Gigahawk/reprapdiscount_smart_controller/ALTIUM_EMBEDDED_MODELS/res0805.STEP

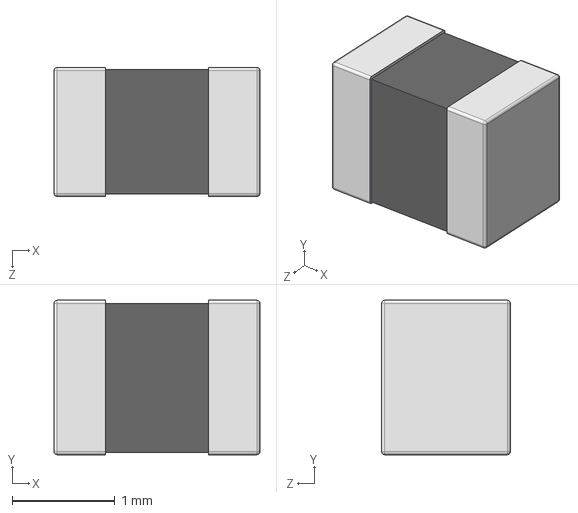
[picture p1: CAD file, 2023-08-28]
ALTIUM_EMBEDDED_MODELS/res0805.STEP
2.00 x 1.50 x 1.25 mm
