Gigahawk/reprapdiscount_smart_controller/ALTIUM_EMBEDDED_MODELS/res1206.STEP

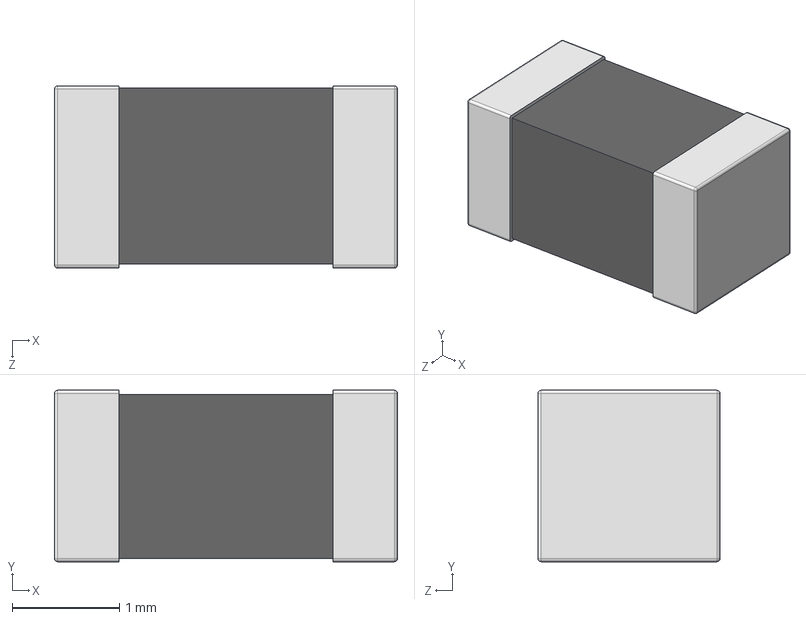
[picture p2: CAD file, 2023-08-28]
ALTIUM_EMBEDDED_MODELS/res1206.STEP
3.20 x 1.60 x 1.70 mm
