Gigahawk/reprapdiscount_smart_controller/(list of files, cad)

Other CAD files:
ALTIUM_EMBEDDED_MODELS/CAP0805.STEP
