Gigahawk/reprapdiscount_smart_controller/reprapdiscount_smart_controller.kicad_pcb

## KiCad design reprapdiscount_smart_controller.kicad_pcb (2023-10-04)

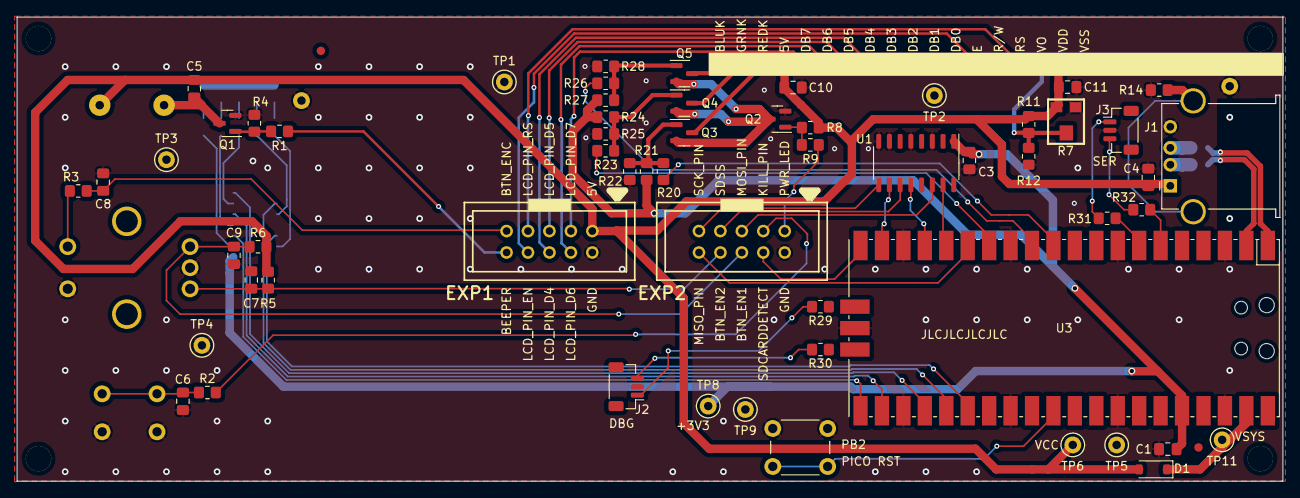
[picture p3: board reprapdiscount_smart_controller.kicad_pcb from above]

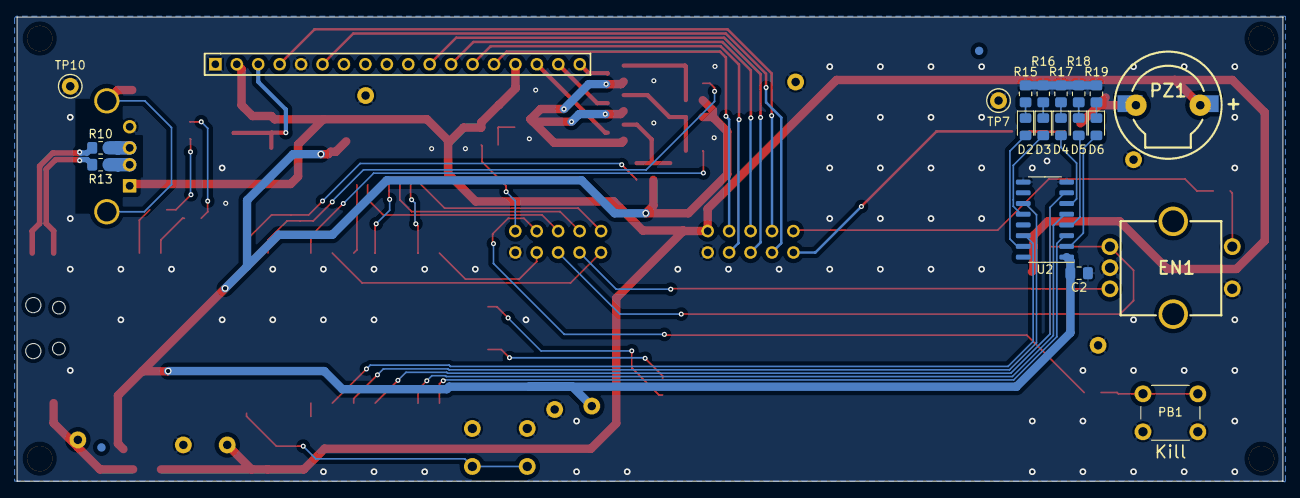
[picture p4: board reprapdiscount_smart_controller.kicad_pcb from below]

Board: 2 copper layers, 150.0 x 55.0 mm, 87 parts (23 on the bottom side), 69 nets.

Parts:
C1, C4, C10, C11: 10u; C_0805_2012Metric_Pad1.18x1.45mm_HandSolder
C2, C3, C5, C6, C7, C8, C9: 100n; C_0805_2012Metric_Pad1.18x1.45mm_HandSolder
D1: MBR120; D_SOD-123
D2: RED; LED_0805_2012Metric_Pad1.15x1.40mm_HandSolder
D3: GRN; LED_0805_2012Metric_Pad1.15x1.40mm_HandSolder
D4: BLU; LED_0805_2012Metric_Pad1.15x1.40mm_HandSolder
D5: YLW; LED_0805_2012Metric_Pad1.15x1.40mm_HandSolder
D6: WHT; LED_0805_2012Metric_Pad1.15x1.40mm_HandSolder
EN1: BC111E5244B2; ROTARY ENCODER
EXP1, EXP2: Header 5X2; HDR2X5_EXP
FID1, FID2, FID3, FID4: Fiducial; Fiducial_1mm_Mask2mm
H1, H2, H3, H4: MountingHole; MountingHole_3mm
J1: USB_A; USB_A_Stewart_SS-52100-001_Horizontal
J2, J3: Conn_01x03_Pin; JST_SH_BM03B-SRSS-TB_1x03-1MP_P1.00mm_Vertical
LCD1: Character lcd; HDR1X18
PB1: STOP; SW_PUSH_6mm_H7.3mm
PB2: PICO RST; SW_PUSH_6mm_H7.3mm
PZ1: PIEZO; PIEZO 11MM
Q1, Q2, Q3, Q4, Q5: DMN2005K-7; SOT-23
R1, R4, R9, R14, R20, R23, R26: 0R; R_0805_2012Metric_Pad1.20x1.40mm_HandSolder
R2: 1k; R_0805_2012Metric_Pad1.20x1.40mm_HandSolder
R3, R29, R30, R31, R32: 100R; R_0805_2012Metric_Pad1.20x1.40mm_HandSolder
R5, R6: 5.1k; R_0805_2012Metric_Pad1.20x1.40mm_HandSolder
R7: 1.4k; RES TRIMPOT
R8, R21, R22, R24, R25, R27, R28: 10k; R_0805_2012Metric_Pad1.20x1.40mm_HandSolder
R10, R13: 22R; R_0805_2012Metric_Pad1.20x1.40mm_HandSolder
R11: DNI; R_0805_2012Metric_Pad1.20x1.40mm_HandSolder
R12: 470R; R_0805_2012Metric_Pad1.20x1.40mm_HandSolder
R15, R16, R18: 91R; R_0805_2012Metric_Pad1.20x1.40mm_HandSolder
R17, R19: 33R; R_0805_2012Metric_Pad1.20x1.40mm_HandSolder
SYM1: Logo_Open_Hardware_Large; OSHW-Logo2_9.8x8mm_Mask
TP1, TP2, TP3, TP4, TP5, TP6, TP7, TP8, TP9, TP10, TP11: TestPoint; TestPoint_Keystone_5000-5004_Miniature
U1, U2: 74HC4050; SO-16_3.9x9.9mm_P1.27mm
U3: Pico; RPi_Pico_SMD_NO_SILK

Connections:
+3V3: C1.2, C2.2, C3.2, R21.2, R24.2, R27.2, TP8.1, U1.1 (+), U2.1 (+), U3.36 (3V3)
BEEPER: EXP1.1, R1.2
BLUK: LCD1.18 (BLUK-), Q5.3 (D)
BTN_EN1: C9.1, EN1.1, EXP2.5, R6.1
BTN_EN2: C7.2, EN1.3, EXP2.3, R5.1
BTN_ENC: C8.2, EXP1.2, R3.1
CONN_D+: J1.3 (D+), R10.2
CONN_D-: J1.2 (D-), R13.2
DBG_RX: R31.1, U3.7 (GPIO5)
DBG_TX: R32.1, U3.6 (GPIO4)
GND: C1.1, C2.1, C3.1, C4.1, C6.1, C7.1, C8.1, C9.2, C10.1, C11.1, EN1.2, EN1.4, EXP1.9, EXP2.9, J1.4 (GND), J2.2, J3.2, LCD1.1 (GND), LCD1.5 (R/W), PB1.2, PB2.2, Q1.2 (S), Q2.2 (S), R4.2, R7.1, R12.2, R14.2, R15.1, R16.1, R17.1, R18.1, R19.1, R22.1, R25.1, R28.1, TP1.1, TP2.1, TP3.1, TP4.1, TP5.1, TP7.1, TP9.1, TP10.1, U1.3, U1.5, U1.7, U1.8 (G), U2.8 (G), U2.9, U3.3 (GND), U3.8 (GND), U3.13 (GND), U3.18 (GND), U3.23 (GND), U3.28 (GND), U3.33 (AGND), U3.38 (GND), U3.42 (GND)
GRNK: LCD1.17 (GRNK-), Q4.3 (D)
HOST_CS: EXP2.4, U1.11
HOST_MOSI: EXP2.6, U1.14
HOST_SCK: EXP2.2, U1.9
LCD4: EXP1.5, LCD1.11 (D4)
LCD5: EXP1.6, LCD1.12 (D5)
LCD6: EXP1.7, LCD1.13 (D6)
LCD7: EXP1.8, LCD1.14 (D7)
LCDE: EXP1.3, LCD1.6 (E)
LCDRS: EXP1.4, LCD1.4 (RS)
LED1: U2.14, U3.26 (GPIO20)
LED2: U2.11, U3.25 (GPIO19)
LED3: U2.7, U3.24 (GPIO18)
LED4: U2.5, U3.22 (GPIO17)
LED5: U2.3, U3.21 (GPIO16)
LEDB: R26.2, U3.12 (GPIO9)
LEDG: R23.2, U3.14 (GPIO10)
LEDK: Q2.3 (D), Q3.2 (S), Q4.2 (S), Q5.2 (S)
LEDR: R20.2, U3.11 (GPIO8)
unnamed: C6.2, PB1.1, R2.1
unnamed: D2.2 (A), U2.15
unnamed: D2.1 (K), R15.2
unnamed: D3.2 (A), U2.12
unnamed: D3.1 (K), R16.2
unnamed: D4.2 (A), U2.6
unnamed: D4.1 (K), R17.2
unnamed: D5.2 (A), U2.4
unnamed: D5.1 (K), R18.2
unnamed: D6.2 (A), U2.2
unnamed: D6.1 (K), R19.2
unnamed: EN1.5, R3.2
unnamed: J1.5 (Shield), R14.1
unnamed: J2.1, R29.2
unnamed: J2.3, R30.2
unnamed: J3.1, R31.2
unnamed: J3.3, R32.2
unnamed: LCD1.3 (Vo), R7.2, R11.2, R12.1
unnamed: C5.1, PZ1.2 (+), Q1.3 (D)
unnamed: Q1.1 (G), R1.1, R4.1
unnamed: Q2.1 (G), R8.1, R9.1
unnamed: Q3.1 (G), R20.1, R21.1, R22.2
unnamed: Q4.1 (G), R23.1, R24.1, R25.2
unnamed: Q5.1 (G), R26.1, R27.1, R28.2
PICO_RST: PB2.1, U3.30 (RUN)
PWR_LED: EXP2.10, R9.2
REDK: LCD1.16 (REDK-), Q3.3 (D)
RESET: EXP2.8, R2.2
SD_CS: U1.12, U3.17 (GPIO13)
SD_DET: EXP2.7, U3.20 (GPIO15)
SD_MISO: EXP2.1, U3.15 (GPIO11)
SD_MOSI: U1.15, U3.16 (GPIO12)
SD_SCK: U1.10, U3.19 (GPIO14)
SWCLK: R29.1, U3.41 (SWCLK)
SWDIO: R30.1, U3.43 (SWDIO)
USB_D+: R10.1, U3.1 (GPIO0)
USB_D-: R13.1, U3.2 (GPIO1)
VCC: C4.2, C5.2, C10.2, C11.2, D1.2 (A), EXP1.10, J1.1 (VBUS), LCD1.2 (Vcc), LCD1.15 (A+), PZ1.1 (-), R5.2, R6.2, R7.3, R8.2, R11.1, TP6.1
VSYS: D1.1 (K), TP11.1, U3.39 (VSYS)
