Gigahawk/reprapdiscount_smart_controller/reprapdiscount_ramps_controller_adapter.kicad_pcb

## KiCad design reprapdiscount_ramps_controller_adapter.kicad_pcb (2023-10-04)

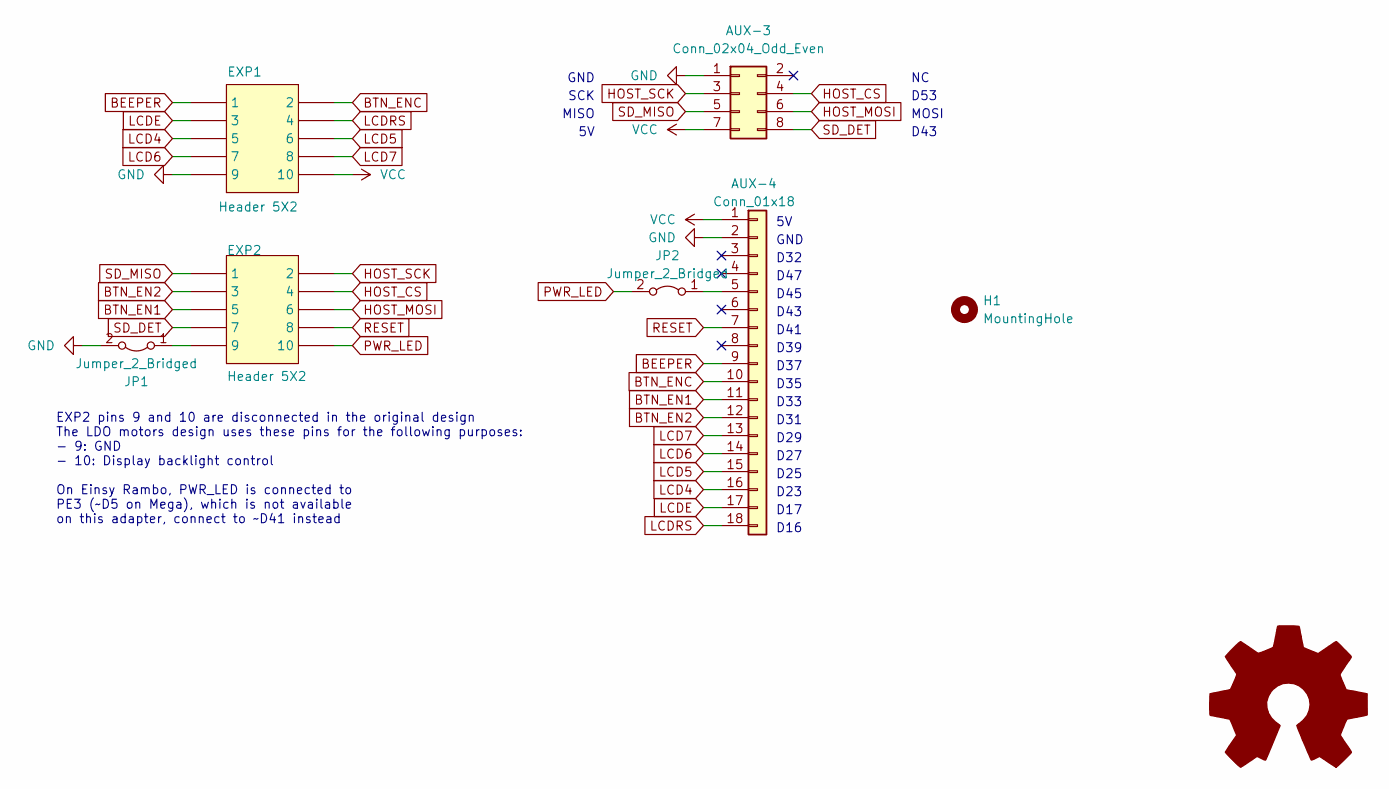
[picture p5: schematic reprapdiscount_ramps_controller_adapter.kicad_sch, RepRapDiscount.com Ramps Smart Adapter]

Parts:
AUX-3: Conn_02x04_Odd_Even; PinSocket_2x04_P2.54mm_Vertical_Flipped
AUX-4: Conn_01x18; PinSocket_1x18_P2.54mm_Vertical
EXP1, EXP2: Header 5X2; PinHeader_2x05_P2.54mm_Vertical; Digikey 1175-1627-ND
H1: MountingHole; MountingHole_3.7mm
JP1, JP2: Jumper_2_Bridged; SolderJumper-2_P1.3mm_Bridged_RoundedPad1.0x1.5mm
SYM1: Logo_Open_Hardware_Large; OSHW-Logo2_7.3x6mm_Mask

Connections:
BEEPER: AUX-4.9, EXP1.1
BTN_EN1: AUX-4.11, EXP2.5
BTN_EN2: AUX-4.12, EXP2.3
BTN_ENC: AUX-4.10, EXP1.2
GND: AUX-3.1, AUX-4.2, EXP1.9, JP1.2 (B)
HOST_CS: AUX-3.4, EXP2.4
HOST_MOSI: AUX-3.6, EXP2.6
HOST_SCK: AUX-3.3, EXP2.2
LCD4: AUX-4.16, EXP1.5
LCD5: AUX-4.15, EXP1.6
LCD6: AUX-4.14, EXP1.7
LCD7: AUX-4.13, EXP1.8
LCDE: AUX-4.17, EXP1.3
LCDRS: AUX-4.18, EXP1.4
unnamed: AUX-4.5, JP2.1 (A)
unnamed: EXP2.9, JP1.1 (A)
PWR_LED: EXP2.10, JP2.2 (B)
RESET: AUX-4.7, EXP2.8
SD_DET: AUX-3.8, EXP2.7
SD_MISO: AUX-3.5, EXP2.1
VCC: AUX-3.7, AUX-4.1, EXP1.10

Notes on the sheet:
D27
D45
D17
EXP2 pins 9 and 10 are disconnected in the original design The LDO motors design uses these pins for the following purposes: - 9: GND - 10: Display backlight control On Einsy Rambo, PWR_LED is connected to PE3 (~D5 on Mega), which is not available on this adapter, connect to ~D41 instead
D32
D37
D35
GND
D23
D43
D53
D47
MOSI
D25
D31
D16
MISO
SCK
D39
D33
D29
D41

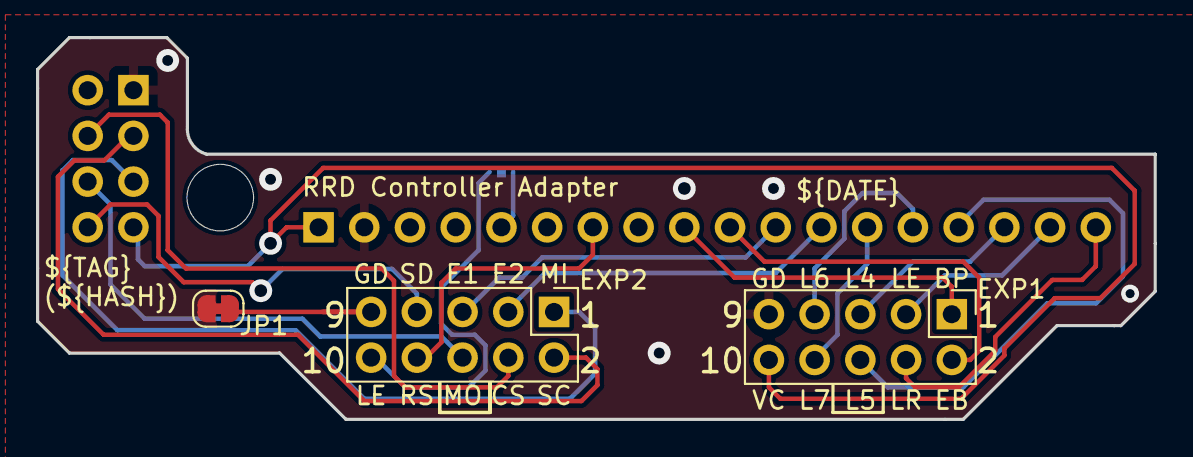
[picture p6: board reprapdiscount_ramps_controller_adapter.kicad_pcb from above]

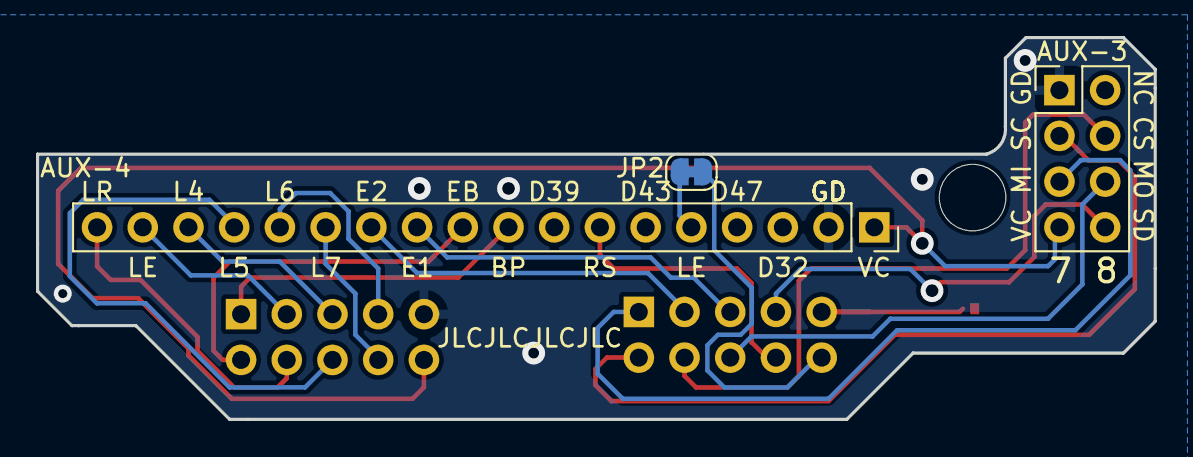
[picture p7: board reprapdiscount_ramps_controller_adapter.kicad_pcb from below]

Board: 2 copper layers, 62.1 x 21.2 mm, 8 parts (3 on the bottom side), 21 nets.
