Gigahawk/reprapdiscount_smart_controller/(commit log)

2023-08-28 import original altium project files
    [smart controller.PcbDoc, smart controller.PrjPcb, smart controller.SchDoc]
2023-08-28 rename files
    [reprapdiscount_smart_controller.PcbDoc, reprapdiscount_smart_controller.PrjPcb, reprapdiscount_smart_controller.SchDoc]
2023-08-28 convert altium files to kicad
    [CAP0805.STEP, reprapdiscount_smart_controller.PcbDoc, reprapdiscount_smart_controller.PrjPcb, reprapdiscount_smart_controller.SchDoc, reprapdiscount_smart_controller.kicad_pcb, reprapdiscount_smart_controller.kicad_sch, res0805.STEP, res1206.STEP]
2023-08-28 generate footprint library from layout
2023-08-28 fixup: fix schematic and layout references
    - replace random 3V3 pth footprints with vias
    [reprapdiscount_smart_controller.kicad_pcb, reprapdiscount_smart_controller.kicad_sch]
2023-08-28 fixup: switch to global net names
    [reprapdiscount_smart_controller.kicad_pcb, reprapdiscount_smart_controller.kicad_sch]
2023-08-28 fixup: switch to kicad native passive symbols
    - redo fill, cleanup broken connections
    [reprapdiscount_smart_controller.kicad_pcb, reprapdiscount_smart_controller.kicad_sch]
2023-08-29 fixup: add all missing 3d models
    [reprapdiscount_smart_controller.kicad_pcb, reprapdiscount_smart_controller.kicad_sch]
2023-09-05 fixup: switch layer names to standard kicad names
    [reprapdiscount_smart_controller.kicad_pcb]
2023-09-05 fixup: specify component types in footprint lib
    [reprapdiscount_smart_controller.kicad_pcb]
2023-09-07 fixup: restore mounting holes lost during cleanup
    [reprapdiscount_smart_controller.kicad_pcb, reprapdiscount_smart_controller.kicad_sch]
2023-09-12 fixup: fix reset button height
    [reprapdiscount_smart_controller.kicad_pcb, reprapdiscount_smart_controller.kicad_sch]
2023-09-12 feature: add parts from ldo-rrlcd-a007
    [reprapdiscount_smart_controller.kicad_pcb, reprapdiscount_smart_controller.kicad_sch]
2023-09-12 feature: add fiducials
    [reprapdiscount_smart_controller.kicad_pcb, reprapdiscount_smart_controller.kicad_sch]
2023-09-13 silkscreen: update to match ldo-rrlcd-a007
    [reprapdiscount_smart_controller.kicad_pcb, reprapdiscount_smart_controller.kicad_sch]
2023-09-13 feature: add back side fiducials
    [reprapdiscount_smart_controller.kicad_pcb, reprapdiscount_smart_controller.kicad_sch]
2023-09-13 feature: add stitching vias
    [reprapdiscount_smart_controller.kicad_pcb]
2023-09-19 feature: add revision info to builds
    [reprapdiscount_smart_controller.kicad_pcb, reprapdiscount_smart_controller.kicad_sch]
2023-09-19 bugfix: switch REVISION var to HASH
    Fixes some conflict in the layout
    [reprapdiscount_smart_controller.kicad_pcb, reprapdiscount_smart_controller.kicad_sch]
2023-09-19 feature: redesign for usb host functionality
    [mechanical.kicad_sch, reprapdiscount_smart_controller.kicad_pcb, reprapdiscount_smart_controller.kicad_sch]
2023-09-19 feature: add order number location
    [reprapdiscount_smart_controller.kicad_pcb]
2023-09-19 layout: remove copper fill around bottom side usb traces
    [reprapdiscount_smart_controller.kicad_pcb]
2023-09-19 layout: slight adjustments to layout
    [reprapdiscount_smart_controller.kicad_pcb]
2023-09-19 layout: minor fixes and adjustments
    [reprapdiscount_smart_controller.kicad_pcb, reprapdiscount_smart_controller.kicad_sch]
2023-09-20 feature: add status leds to pico
    [reprapdiscount_smart_controller.kicad_pcb, reprapdiscount_smart_controller.kicad_sch]
2023-09-20 ci: export bom
2023-09-22 feature: use buffer to drive leds
    [reprapdiscount_smart_controller.kicad_pcb, reprapdiscount_smart_controller.kicad_sch]
2023-09-22 bom: specify digikey part numbers
    [mechanical.kicad_sch, reprapdiscount_smart_controller.kicad_sch]
2023-09-25 feature: support adafruit rgb display
    [buffers.kicad_sch, buzzer.kicad_sch, connectors.kicad_sch, display.kicad_sch, inputs.kicad_sch, pico.kicad_sch, reprapdiscount_smart_controller.kicad_pcb, reprapdiscount_smart_controller.kicad_sch]
2023-09-25 feature: add pico debug connections, testpoints
    [mechanical.kicad_sch, pico.kicad_sch, reprapdiscount_smart_controller.kicad_pcb]
2023-09-25 bom: update bom
    [mechanical.kicad_sch, pico.kicad_sch]
2023-09-25 cleanup: remove vias blocking silkscreen
    [reprapdiscount_smart_controller.kicad_pcb]
2023-09-26 schem: export revision info to all sheets
    [buffers.kicad_sch, buzzer.kicad_sch, connectors.kicad_sch, display.kicad_sch, inputs.kicad_sch, mechanical.kicad_sch, pico.kicad_sch]
2023-09-26 schem: fix page numbering
    [reprapdiscount_smart_controller.kicad_sch]
2023-10-03 adapter: add adapter based on released gerbers
    [reprapdiscount_ramps_controller_adapter.kicad_pcb, reprapdiscount_ramps_controller_adapter.kicad_sch]
2023-10-03 adapter: finish routing
    [reprapdiscount_ramps_controller_adapter.kicad_pcb, reprapdiscount_ramps_controller_adapter.kicad_sch]
2023-10-03 adapter: update silkscreen
    [reprapdiscount_ramps_controller_adapter.kicad_pcb]
2023-10-03 adapter: clean up schematic
    [reprapdiscount_ramps_controller_adapter.kicad_pcb, reprapdiscount_ramps_controller_adapter.kicad_sch]
2023-10-03 adapter: setup ci
    [reprapdiscount_ramps_controller_adapter.kicad_sch]
2023-10-03 adapter: add ldo connections
    - adapter: update silkscreen
    [reprapdiscount_ramps_controller_adapter.kicad_pcb, reprapdiscount_ramps_controller_adapter.kicad_sch]
2023-10-03 adapter: adjust routing
    [reprapdiscount_ramps_controller_adapter.kicad_pcb]
2023-10-03 adapter: minor layout and silk adjustments
    [reprapdiscount_ramps_controller_adapter.kicad_pcb]
2023-10-03 adapter: minor track adjustments
    [reprapdiscount_ramps_controller_adapter.kicad_pcb]
2023-10-03 adapter: move revision info silk
    [reprapdiscount_ramps_controller_adapter.kicad_pcb]
2023-10-04 all: add oshw logo to design
    [reprapdiscount_ramps_controller_adapter.kicad_pcb, reprapdiscount_ramps_controller_adapter.kicad_sch, reprapdiscount_smart_controller.kicad_pcb, reprapdiscount_smart_controller.kicad_sch]
